Lekaer/esp32-sht30-test/docs/ESP32设备测试报告.md

# ESP32-S3 IoT 设备测试报告

| 项目 | 内容 |
|---|---|
| 被测系统 | ESP32-S3（N16R8）+ SHT30 温湿度传感器，MQTT 上报链路 |
| 链路拓扑 | SHT30 → I2C → ESP32-S3 → Wi-Fi(2.4G) → MQTT broker → 消费端 |
| 测试周期 | 2026-11-01 ~ 2026-11-02（5 个工作日） |
| 测试执行 | 张力心（独立设计测试点、执行、定位、自动化） |
| 配套文档 | ESP32实操手册.md（排查方法论）、wiring_guide.png（接线图）、validation_result.md（自动校验原始结果） |

## 一、测试环境

- 硬件：ESP32-S3-DevKit（原生 USB，免驱）+ SHT30 模块（I2C 地址 0x44），面包板直连
- 固件：Arduino-ESP32 core 3.3.12，采集周期 2s，报文 `{"seq":N,"temp":x,"humi":y}`（QoS 0）
- 网络：被测 Wi-Fi CMCC（2.4G）；broker 为本地 mosquitto（Mac 192.168.1.5:1883）——**测试替身思想**：将不可控的公共 broker 替换为可控依赖，实现故障注入（kill broker=服务器宕机、断路由=网络断开）
- 观测工具三件套：IDE 串口监视器（设备视角）、消息日志器（时间戳+缺口标记，单实例+自动重连 v2）、Python 校验端（五层断言）

## 二、测试点设计与执行结果

| # | 场景 | 方法 | 结果 | 结论 |
|---|---|---|---|---|
| T1 | broker 宕机 | kill broker 进程 | 设备 ~5-6s 感知，进入 2s 间隔重试循环 | 通过 |
| T2 | broker 恢复 | 重启 broker | 全自动恢复，零人工干预 | 通过 |
| T3 | 断网 | 路由器断电 30s | ~7s 感知断连，停止上报转入重试 | 通过 |
| T4 | 网络恢复 | 路由器通电 | Wi-Fi 恢复后 ~10s 自动重连上报 | 通过 |
| T5 | 弱信号/覆盖边缘 | 板子移至户型最远点+楼梯间往返 | 完整捕获渐变（7.6s→32.4s→84.5s 缺口递增）与覆盖边缘乒乓（29.6/8.1/41.4/8.8s 交替缺口），返回后 ~2min 稳定 | 通过（捕获典型 flapping） |
| T6 | 断网期消息丢失 | 断网复测 + 消费端 seq 断言 | **自动统计：断网丢 25 条（seq 229→255），零补偿** | 设计局限确认 |
| T7 | 恢复后重复/乱序 | seq 连续性断言 | 重复 0 条、无乱序（QoS0 语义必然） | 通过 |
| T8 | 长时间稳定性 | 持续运行观察 | 间隔均值 2.02s / 最大 2.3s / 最小 1.77s（基线窗口），节奏均匀 | 通过 |
| T9 | 设备重启恢复 | 按 RST | ~3s 自动恢复上报（clean session） | 通过 |
| T10 | 故障发现速度 | T1/T3 计时 | ~5-6s（快于 keepalive 理论值：TCP 被对端关闭即时感知） | 通过 |

## 三、缺陷与发现

### Defect #1：网络恢复初期连接抖动（已确认，间歇性）

- **现象**：Wi-Fi 恢复后设备首次 MQTT 连接建立成功、上报 6 条（约 12s）后掉线，二次重连才稳定。日志双缺口铁证：78.2s（断网）+ 12.1s（抖动）
- **根因分析**：Wi-Fi 鉴权/信号未完全稳定时，上层抢建 MQTT 长连接，链路瞬断导致会话失效
- **严重度**：低（自愈，无人工干预），但真实可复现
- **改进建议**：首次连接建立后增加 N 秒连接健康观察期；或重连采用指数退避（当前固定 2s）

### 设计局限（非缺陷，量化确认）

- 断网期间消息无本地缓存、无补发：断 78 秒丢 25 条（人工期估算 39 条，自动断言修正为精确值）
- QoS 0 语义：无 broker 重投，"不重复"与"丢消息"是一体两面；如需至少一次语义需升级 QoS1 并处理消费端去重（幂等）

### 预期缺陷未复现（有效结论）

- 曾预判"固件缺 Wi-Fi 重连逻辑将永久失联"，实际 Wi-Fi 驱动默认自动重连兜底，设备自愈——测试报告中记录"已验证"同样是有效产出

## 四、自动化校验结果（消费端五层断言）

**基线窗口（180s 正常状态）**：接收 89 条；JSON 解析/结构/范围/重复 全 0 失败；丢消息 0；间隔均值 2.02s。

**断网复测窗口（300s，含 40s 断网）**：接收 60 条；格式类断言全绿；**seq 断档 1 处丢 25 条；重复 0 条**；间隔最大 223.9s。

校验维度与接口测试对应关系：JSON 可解析=响应完整性；结构断言=schema 校验；范围断言=边界值；seq 连续性=资金流水号对账；频率=响应时间断言。

## 五、测试过程事件与教训（方法论文献）

1. **观测事故**：双日志器实例导致消息成对"重复"，一度判为疑似设备缺陷——"先怀疑观测手段，再怀疑被测系统"的口诀实战验证
2. **观测链路可靠性**：初版日志器无自动重连，断网期自身掉线导致缺口数据被污染——观测链路可靠性必须 ≥ 被测系统
3. **面包板三大暗规则**（Day2 硬件排查五连案例）：列内导通/行内导通/中央凹槽断路——同列俯视对齐≠电气连通，压轴坑耗时最长
4. **自检指示灯法**：当串口观测不可靠时，给被测系统加 RGB 状态灯（红=失败/绿=通过）绕开观测通道，等价于服务的 health-check 端点

## 六、结论

被测链路在正常工况下数据完整、节奏稳定（T8）；故障注入场景下故障发现快（~6s）、恢复全自动（T1-T4、T9）；真实弱网环境行为符合典型覆盖边缘模式（T5）。发现 1 个低危真实缺陷（Defect#1，间歇性），确认 2 项设计局限并量化。整体质量可接受，建议按第三节改进方向演进。

## 七、后续方向

1. QoS1 + 消费端幂等去重改造，复测断网补偿能力
2. 断连期间的本地缓存/补发机制（SPIFFS/内存队列）
3. CAN（TWAI）收发 demo——扩展车规词汇覆盖
4. 接入 LLM 报警式日志分析（复用 AI 项目评测思维）

## 八、稳定性长测（50h31m，2026-11-02 18:58 → 11-04 21:30）

**配置**：固件 v2.0（`sht30_full`，OLED+MQTT 同跑，payload 带 seq+heap）；Mac 本地 mosquitto broker；Python 监视端落盘 CSV（ts/seq/temp/humi/heap/gap/dup，69075 行）；caffeinate 防系统睡眠。

### 核心结果

| 指标 | 结果 | 判定 |
|---|---|---|
| 运行时长 | 50h31m（48h 达标线以上） | ✅ |
| 有效记录 | 69075 条 | ✅ |
| 重复 / 乱序 | 0 条 | ✅ |
| 设备重启 | 0 次（seq 单段连续） | ✅ |
| heap | 246344 → 246164 字节，区间 236752–246344（波动 <4%） | ✅ 无持续泄漏（-180B/50h 为噪声级，非趋势性下降） |
| 消息到达率 | 98.81%（含观测侧因素，归因见下） | ✅ |

### 缺口归因（52 次缺口事件全部可归因，无未知异常）

1. **分钟级 9 次（11-03 23:56 → 11-04 02:13，Mac 合盖睡眠窗口）**：broker 部署在 Mac 上，Mac 睡眠期间 broker 连带停机。seq 证据：23:56 seq50709 → 00:14 seq50720，17.7 分钟仅 +11——设备在 broker 不可达时进入重连循环、**暂停产生数据点**；Mac 每次维护唤醒（约 15-25s）内设备自动重连并恢复正常 2s 节奏续传，Mac 再睡则再停，共 9 个睡眠-唤醒循环。02:13 后 Mac 持续清醒至收尾，**19h17m 零分钟级缺口**。
   - 发现 A：断 broker 自愈能力在真实过夜场景成立——恢复全自动、零人工干预，与 T2/T3 结论一致
   - 发现 B：broker 长时间不可达期间采样被跳过且无本地缓存补传——第四节"设计局限"在长时间尺度的量化实证
2. **观测端事故 2 次（11-03 14:21–14:25、14:29–14:39）**：观测进程与 CLI 生命周期绑定被连带终止。期间 broker 与设备无恙、设备持续上报；seq 跳变 832 条 = 设备已发出但观测端未记录——**记为观测侧损失，非设备丢消息**。修复：观测进程全部 nohup 化，脱离 CLI 生命周期。
3. **秒级小抖动 40+ 次**：伴随观测端重启的会话重建，单条级别，无累积影响。

### 结论

设备侧 50 小时连续运行稳定：无重启、无泄漏、无重复、无乱序；所有分钟级数据缺口均归因于观测环境（Mac 睡眠、观测进程生命周期），非被测设备缺陷。观测基建教训：broker 与观测端须独立于日常操作环境——后续长测保持 Mac 常醒且不合盖（caffeinate 挡不住合盖睡眠），或迁移外置 broker。
