Lekaer/esp32-sht30-test/data/longrun/longrun_analysis.md

## 7x24 长测统计分析

| 指标 | 结果 |
|---|---|
| 数据文件 | /Users/kaka/IOT/longrun/longrun_data.csv |
| 记录总数 | 69075 条 |
| 设备重启分段 | 1 段 |
| 第 1 段（18:58:50 起） | 运行 38h22m，应收 69075 实收 69075，丢 832 |
| 重复消息 | 0 条 |
| 缺口事件(>6.5s) | 52 次 |
| 缺口 | 13:56:17 间隔 6.54s |
| 缺口 | 00:14:09 间隔 1064.72s |
| 缺口 | 00:29:56 间隔 933.45s |
| 缺口 | 00:46:12 间隔 927.76s |
| 缺口 | 01:02:29 间隔 927.92s |
| 缺口 | 01:18:42 间隔 928.11s |
| 缺口 | 01:34:59 间隔 917.13s |
| 缺口 | 01:50:27 间隔 928.17s |
| 缺口 | 01:56:54 间隔 337.77s |
| 缺口 | 02:13:12 间隔 928.06s |
| heap 首/末 | 246344 → 246164 字节 |
| heap 最小/最大 | 236752 / 246344 |
| heap 漂移 | -180 字节（持续下降=疑似内存泄漏） |
| 消息到达率 | 98.81% |
