Lekaer/esp32-sht30-test/docs/wiring_guide.png

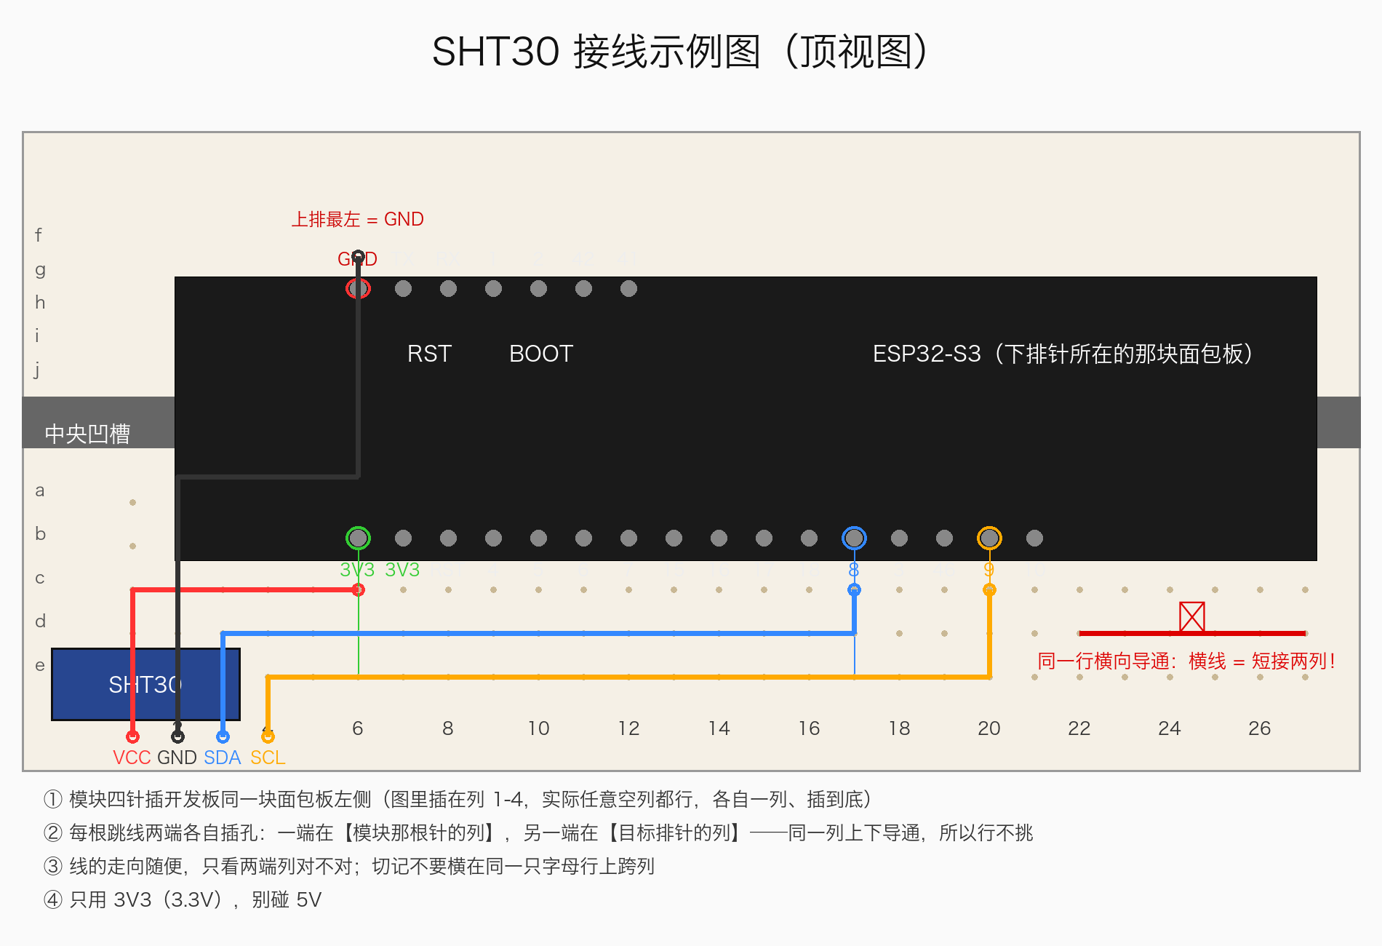
docs/wiring_guide.png
