Lekaer/esp32-sht30-test/data/validation_result.md

## 校验结果（窗口 180s，16:44）

| 指标 | 结果 | 判定 |
|---|---|---|
| 接收消息总数 | 89 | |
| JSON 解析失败 | 0 | ✅ |
| 结构断言失败 | 0 | ✅ |
| 范围断言失败 | 0 | ✅ |
| 丢失消息（seq 断档） | 0 条，断档 0 处 | |
| 重复消息（seq 重复） | 0 条 | ✅ |
| 消息间隔 | 均值 2.02s / 最大 2.3s / 最小 1.77s | 期望≈2s |

## 校验结果（窗口 300s，16:52）

| 指标 | 结果 | 判定 |
|---|---|---|
| 接收消息总数 | 60 | |
| JSON 解析失败 | 0 | ✅ |
| 结构断言失败 | 0 | ✅ |
| 范围断言失败 | 0 | ✅ |
| 丢失消息（seq 断档） | 25 条，断档 1 处 | |
| 重复消息（seq 重复） | 0 条 | ✅ |
| 消息间隔 | 均值 5.78s / 最大 223.9s / 最小 1.87s | 期望≈2s |

**丢消息明细**：
- seq 229 → 255，丢 25 条
