Lekaer/esp32-sht30-test/(commit log)

2026-11-02 ESP32-S3 IoT 测试链路：SHT30 I2C 采集 + MQTT 上报 + 弱网测试 10 场景 + 消费端五层断言
    - 固件：seq 序号 JSON 报文，本地 mosquitto 作可控测试替身
    - 缺陷：Defect#1 网络恢复初期连接抖动（间歇性，日志双缺口铁证）
    - 自动化统计：断网丢 25 条（seq 229->255），恢复重复 0
    - 文档：设备测试报告 / 实操手册（S3 四手感/串口三板斧/面包板三大暗规则）
    - 工具：mqtt_logger（时间戳+缺口标记）/ mqtt_validator（JSON/结构/量程/seq连续/频率）
2026-11-02 新增带屏温湿度计原型：SHT30+OLED 共享 I2C 总线，含传感器离线异常路径（拔线显示 offline 不卡死）
    验收 4 测试点全过：正常显示/捂手升温/异常提示/自动恢复
2026-11-02 README 更新目录说明
2026-11-02 固件v1.1：payload 增加 heap 字段（长测内存泄漏监测）
2026-11-02 固件v2.0 产品完全体：OLED 显示 + MQTT 上报合并，屏幕含 MQTT 状态栏（弱网测试可视观测）
2026-11-04 50h 稳定性长测收尾：报告第八节（52 次缺口全归因，设备侧无重启/无泄漏/零重复）+ 原始数据 69075 条 + 长测监视/分析工具
    [longrun_data.csv]
